PNKP237/EHU32/EHU32_wiring.pdf

PCM5102 module | ESP32 DevKit get one with an antenna connector for best results

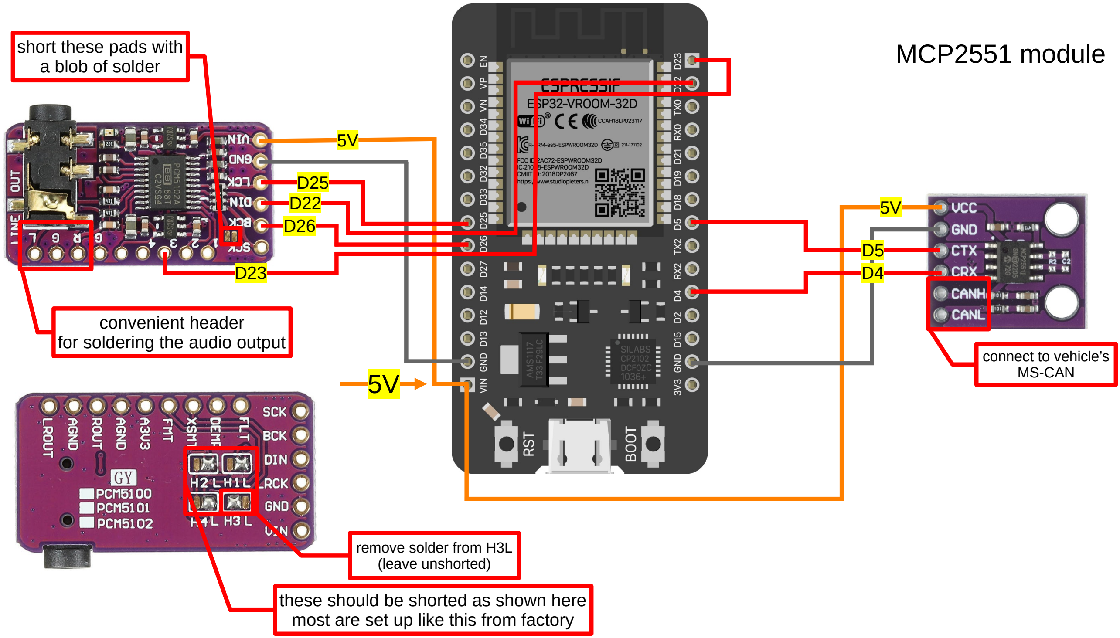
[picture p1: figure]
remove solder from H3L (leave unshorted); these should be shorted as shown here most are set up like this from factory; short these pads with a blob of solder; connect to vehicle’s MS-CAN; convenient header for soldering the audio output; MCP2551 module
