PNKP237/EHU32/(threads)

Thread 2 (2024-04-20):

About canUpdateDisplay() function

eticaretmuhendisi, 2024-04-20:
Hello, congratulations for your project.
I am trying to make a simpler project. I found this version of the project a bit confusing. Could you please share the write to screen function in a simpler way?

PNKP237, 2024-04-20:
For writing to the screen, I would suggest taking a look at this: [Info-Display.md](https://github.com/JJToB/Car-CAN-Message-DB/blob/master/Opel/Astra/H/MS-CAN/Info-Display.md) and also at the small writeup on the [wiki page here](https://github.com/PNKP237/EHU32/wiki). Good understanding of [ISO 15765-2](https://en.wikipedia.org/wiki/ISO_15765-2) will probably make it easier to figure out and implement in your own application.

canUpdateDisplay() is only called when ESP32 detects the screen being written to by the radio unit (specifically, the first message). At this point there is few things that can be done:
- wait for radio to finish sending its text and then send our own text (results in flashing "Aux")
- prevent radio from updating the display by abusing flow control packets (will only work if we're faster than the display in acknowledging the transmission). This is the prettier option becuase "Aux" is not shown at all.

Updating the display is somewhat convoluted in the case of EHU32 because I opted to make it possible to update from various sources, make it flexible and memory safe (to the best of my ability). The functions operate on 1-byte buffers existing in the global scope: utf16buffer (formatted text, converted into UTF-16, with everything calculated, modified by utf8_conversion), CAN_MsgArray (utf16buffer split into packets as per ISO 15765-2, ready for transmission, modified by prepareMultiPacket).
The process of writing text to the display is as follows:
- call prepareMultiPacket(utf8_conversion("string one", "string two", "string three"));
- make sure the radio is not sending a message of its own,
- transmit ONLY the first message from CAN_MsgArray (sendMultiPacket does this, sets the flag - CAN_MessageReady - for the main loop to act upon),
- wait for the display to acknowledge with a flow control message (main loop does this based on the flag, waits for the message from the display with ID 0x2C1),
- send rest of the messages from CAN_MsgArray (calling sendMultiPacketData does this until the packets do not contain the consecutive frame index)

It is also good practice to make sure the messages are sent successfully and aborting the transmission in case of even a single error.

Thread 3 (2024-05-04):

Additional information without electric climate

Vortecsz, 2024-05-04:
Hello, would be possible to display coolant, speed, rpm and voltage without the Electronic climate? I know how to activate the electronic climate tab in the bottom but I don't have the automatic climate so this is useless for me. Would be possible to show maybe the coolant and battery in the first page of the screen without auto climate? If not why? The data are pulled from the ECC or is something related to the print on the display? If the problem is the ECC I could search for the different address of the data's in the can line? If the problem is the print why I couldn't print in the first page? Thank you so much for the work!

PNKP237, 2024-05-04:
Battery is out of the question for now, I haven't been able to come up with a way to read battery voltage from MS-CAN other than through ECC.
As for coolant temp and vehicle speed, it is possible to read it using measurement blocks from the display (but then there's no RPMs nor voltage). I'll try to implement that in the next version (it will try reading reduced data from display if there is no response from ECC) - I guess you can expect the new version in one or two weeks, still optimizing and testing stuff.
As for why - it uses the same protocol that OPCOM or Tech2 use for reading measurement data and only ECC offers coolant temp, speed, rpms and voltage combined. If these tools can't access more data from display or radio neither can we.

Haven't had much luck with sniffing the coolant, rpm and speed data like it was defined [HERE](https://github.com/JJToB/Car-CAN-Message-DB/blob/master/Opel/Astra/H/MS-CAN/Body.md). In my case (Z16XER) I was reading total garbage, but once I get reading basic data from the display done I'll try again with these.

Vortecsz, 2024-05-04:
Love to hear that, it would be possible to display like the coolant in the first page? I would like to have the coolant temperature in the main page without need to swap page everytime

PNKP237, 2024-05-05:
First page as in the mode where song data is shown? I guess I can make it like this but it would require me to rewrite a lot of current logic.
I would much rather show the coolant temp in a "notification box" that sometimes appears in the top right corner of GID/CID, able to be toggled on or off. Do you think that would work for you?

Vortecsz, 2024-05-05:
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
That's my current setup, in the top the current media, like aux etc in the bottom consumption etc, my main goal would be to add like coolant in the top right, but if is it hard, I would understand maybe one day I will understand how to program that haha. The notification box would be also not bad at all

PNKP237, 2024-05-05:
Alright, you have a single line GID so writing the coolant info to the album or artist fields won't work because you won't see them anyway. I had the single line version as well but I enabled UHP just to make it display all the three lines of text.
The notification box will work fine but it will obstruct the top right part of the display.

As for GID firmware, EEPROM only holds basic data such as settings and carpass (if paired with the radio). and the GID firmware itself is held inside this TSOP flash package I think, difficult to read that data without a TSOP adapter. Don't feel the need to modify the GID firmware anyway, I'd like this project to work plug-and-play with no modification to the rest of the system

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

Vortecsz, 2024-05-05:
Oh okay, would be possible to print in the top right with the single line gid? Or just you can't because u need to overwrite an existing text? Like artist aux etc. Btw with the the EEPROM firmware you can change different version 3 line version, single etc, but if you don't want to modify any firmware that's pretty useless.
I don't know if you know but a Russian guy seel an obd device probably something similar to your setup, that can show DPF status etc, that's only an idea for the project, I don't need DPF status etc. My main focus is to see the coolant temperature and maybe battery in the main page as stock as possible. Because Opel decided to not add any temperature gauge in the cluster...
Thank you for the help.

PNKP237, 2024-05-05:
Yes the notification box can be displayed even with single line GID.
As I have already stated in the [other issue](https://github.com/PNKP237/EHU32/issues/1) there is no way to read DPF status from MS-CAN and that's the only CAN bus I'm going to support in this project, mainly because ESP32 only has a single CAN peripheral. Otherwise I would need additional hardware to be able request DPF measurement blocks from ECU through HS-CAN.
I recently learned that such module exists but making menu interfaces is not something I would like to focus on at this time even though I have already reverse engineered how the menu can be created.
The problem is that if this is put in a vehicle equipped with UHP it could cause problems because that module "fakes" being an UHP interface menu

PNKP237, 2024-05-05:
Nevermind, the notification box does not show up when the main audio page is displayed. I guess I'll try to fit coolant info on the right of the middle line or find another way to display notifications
I'm surprised you prefer the single line version though

Vortecsz, 2024-05-05:
Oh okay, I prefer the single line because I watch a lot the consumption and the autonomy of the car so I would need to swap page every time. The first page of the three line only display audio information and I only use aux so I would of see aux and nothing more. I prefer to see the consumption

PNKP237, 2024-05-05:
The display is not very good at handling longer strings and as a result the coolant temp is printed on top of the title text. Sometimes it's ignored and not printed at all, for very long song titles

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

I don't know if I should go ahead with this, the result is kinda bad

Vortecsz, 2024-05-05:
You are right, that's not good at all for posting it, I don't know if you can put the string down the song or you can just write in the line of artist/song name. Btw can you give me the code? I can use the coolant on the right of the AUX string? Because I just use aux so is not a problem for me and thank you for all the help and the amazing work you are putting in the project.

PNKP237, 2024-05-05:
You can't "add" anything to the AUX string sent by the radio, you can only overwrite it.
I built this test version on top of EHU32 which is still not ready for release, but once it's finished I'll give you the code with this functionality added, with a way to customize the text displayed to your liking

Tomi8609, 2024-05-06:
I will keep an eye on this part of the project!

PNKP237, 2024-05-06:
Just pushed v0.9, added an additional mode (accessible by long pressing "3") for displaying just the coolant temp in a single line, looking like so:
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

Vortecsz, 2024-05-07:
That's beautiful thank you so much for the work! Currently waiting for the esp and the modules to arrive to get it working.

Wop57, 2024-05-12:
There is an example for showing information in the electronic climate tab. It is in the issue #3 in the Car-CAN-Message-DB of JJToB. Here is the link:
https://github.com/JJToB/Car-CAN-Message-DB/issues/3

PNKP237, 2024-05-12:
> There is an example for showing information in the electronic climate tab. It is in the issue #3 in the Car-CAN-Message-DB of JJToB. Here is the link: [JJToB/Car-CAN-Message-DB#3](https://github.com/JJToB/Car-CAN-Message-DB/issues/3)

Thanks, never noticed that one.
Even though I have considered showing the temperatures there it still does not solve the underlying issue - if the car does not have ECC (or at least not enabled in Display Variant Programming, changing which requires opcom, which kinda defeats the "as cheap and easy as possible" approach) then we can't utilize that field.

Already tested with UHP but it does not send any notification boxes, only menu-like screens.
I'll do some additional research to see if I can simulate Navi notifications, but that has to wait since I'm super busy with other things. Also I need to get the CD ROM drive back into my Navi since it refuses to display anything without the drive mechanism.

Vortecsz, 2024-05-15:
Hello is possible to change the pinout with this board?
CP2102 Type-C 38P

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

PNKP237, 2024-05-16:
I don't exactly understand what do you mean by "change the pinout", please elaborate.
Is it just changing the pins, as in you'd prefer the CAN TX/RX or I2S on different pins than provided in my example?

Vortecsz, 2024-05-16:
Oh yes sorry, I searched for the defaults pin out of can Rx tx and i2s, example for can Rx and tx io4 and io5  wired them up in my esp board but isn't working at all. Maybe is the board? And I need to define manually the gpio? I find that the default pins are the same for the 38 pins board and the 30 pins board so I don't know why isn't working

Vortecsz, 2024-05-16:
After reflashing the esp every time I connect the board to the car the aux text go away and the current date is displayed is like the radio doesn't work because the buttons don't do nothing but I can hear the sound from the speaker so the radio is on. If I remove the esp everything work as usual

PNKP237, 2024-05-16:
Curious. I do most development on a setup like yours (GID and I assume CD30MP3) and never had the radio stop responding. What model year is your vehicle?

PNKP237, 2024-05-16:
i2s is just an output and if you leave it not connected it does not matter to the ESP32 at all (it doesn't receive any data from PCM5102).

EHU32 will enable bluetooth and start sending stuff to the screen after it notices that the radio has sent some text to the display, it starts with the "1" mode active (audio metadata). You don't have to connect to switch to the "3" mode (1-line coolant info).

If you can, please download version 0.7 from releases and try connecting your phone and playing something to see if the audio title is displayed at all. Of course it won't have the "3" mode and "2" won't work but I would like to see if the "radio message blocking" feature is the problem here (v0.7 is the last version without it).

Vortecsz, 2024-05-16:
Okay, my problem is the 5v and grounds using a car charger with USB port. Gonna try others configuration. Anyway mode 1 work with song names, mode 2 show coolant hope I'm correct, mode 3 show speed and rpm, the rpm and speed are wrong when I'm idle at 800 it shows 3000 same for the speed I'm going 90kmh and it shows 45. Mode 2 coolant is partially wrong if I long press settings and after bc I can access the secret menu of the gid and I can see the little difference between the two coolant value, your is a bit high like 3/4 °c. The audio quality sucks, but that's my problem with the connection, I would love to see you PCB design did you manage to get that done?

PNKP237, 2024-05-16:
It's the other way around, mode 2 should show speed and RPMs and if there is no ECC detected it will try to pull that data from CAN but as I said earlier in my vehicle I would read random values so I haven't had much luck testing that. I guess I'll remove that option from next version since it doesn't work that well - I'll make it only show speed that's read from the display.

I think that the ground of the audio input in CD40 might be either floating or coupled with caps to ground, I'd suggest to measure with a multimeter between the audio input ground and vehicles ground to see if there is any voltage there. If there is then one fix would be to either modify the radio or buy some kind of an audio separation transformer.

Thanks for the feedback, I'll correct the speed display (just divide it by 2 I guess?) when I have some free time next week to possibly test it within my vehicle. As for coolant I'd say it's the GID that's lying since these cars notoriously run hot.
As for the PCB... I'll get around to finish it one day but I've got a lot of things going on right now.

Vortecsz, 2024-05-16:
Okay I resolved all the problem with the connections, the problem is that the audio quality sucks really bad. I don't know why the power is from a car charger with a USB cable, not from the radio.

PNKP237, 2024-05-17:
I hope your PCM5102 isn't broken, here's a test program for you to flash the ESP32 with, please connect it to an amplifier at home so you can check whether the audio output works properly. It has no CAN functionality so you can connect to it and just play music from your phone.
[ESP32_Audio_Stereo.zip](https://github.com/PNKP237/EHU32/files/15345653/ESP32_Audio_Stereo.zip)

Vortecsz, 2024-05-19:
As soon as I have a chance I'll try it thank you very much. Just a question: the ESP power supply should be given through the USB connector or i can give it directly to the vin and gnd pins?

PNKP237, 2024-05-20:
Yes, you can power the board through the VIN pin, on some boards it's connected the same 5V line as the USB VBUS pin, on other boards it's connected through an additional diode. Just make sure you don't power the board through VIN and through the USB connector (from PC) both at once.

Vortecsz, 2024-05-20:
Perfect all working i found some problem; the qualitify of the music is not the best, the sound has some distortion in the background, i'll attach a video below. Sometimes the esp(i think) crashes and the bluetooth is disconnected, and the can also, after some seconds it recconect automatically. Did your setup also have some distortion noise with the aux? I have an aux bluetooth buyed from amazon and it doesn't has background noise

https://github.com/PNKP237/EHU32/assets/61433353/eaeeabb6-ca29-4399-9362-cfa626972faa

PNKP237, 2024-05-20:
I found that the ESP is prone to crashing when the 5V source is not very good. Did you try with additional electrolytic capacitors soldered to the ESP32 board, between VIN and GND? ESP32 is way more power hungry compared to those bluetooth audio boards found everywhere, which is what I used before. My own setup uses a linear 5V regulator (7805) taking power from the radio itself with many additional capacitors on the 12V and 5V lines.
Distorted sounds like in your video do happen in case the I2S driver has no new data to process (it loops the last received music sample, often when bluetooth gets disconnected or gets out of range) or during a crash, but it's never that long, maybe 1 sec max.
I have honestly not used the external aux much since I bought a CD70 from scrapyard and it has no aux circuitry (therefore my EHU32 is soldered inside the radio directly to aux). Although I did test it briefly with the original CD30MP3 (EHU32 connected to external aux and OBDII port) my car came with and I only had some slight noise from unsmoothed DC-DC converters when I tried to power it with the worst quality step down board I could source.

Vortecsz, 2024-05-20:
I'm currently taking the power from an 12v car charger, so i don't think the power sucks. I can use the 7805 as you said? Right now i'm testing all the setup, i'm planning to take the power from the radio as well. For now i can use the 7805 after my car charger (5v)? That one? ; [https://it.aliexpress.com/item/1005006104819794.html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](url)

PNKP237, 2024-05-21:
I should probably clarify in the readme that you should not use the phone's volume control and leave it on max since volume control on I2S results in the audio quality getting worse (the lower the volume, the less bits per sample of audio there is).
Only use vehicle's volume control and optionally you can go into CD40 settings and modify the "Aux in volume" to a value of -5 to lower the noise floor.

The best setting for the CD30 family (so CD40USB as well) would be to use the 7805 inside the radio, it makes the experience more seamless since it powers on/off with the radio itself by using the switched 12V or 8V voltage rail inside the radio unit, but an ESP32 module with an antenna is highly recommended because the radio cage acts like a shield. I actually did test it inside the CD30MP3 as well and the method of connecting it inside should work for CD40 as well.
As for caps I think I've got 470uF + 100nF on the input of the 7805 and 1000uF + 100nF on the output, additionaly there is a 220uF cap soldered directly to the PCM5102 board. MS-CAN is hooked up directly to the legs of TJA1041 CAN transceiver, audio is soldered to the internal AUX vias. Power can be taken either from switched 12V (on the tab of this large SOT-223 package on the right) or from a 8V rail powering the CD drive.
Here are the photos of the mod:
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
Internal Aux vias:
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
white is left channel, black is audio ground, red is right channel

Vortecsz, 2024-05-22:
Thanks so much, I'll follow your "schematic" as soon as I can. Btw,my radio hasn't worked in FM mode for a year now, it remains in search and no noise is emitted, do you have any idea what it could be?  Has it ever happened to you? Sorry for the OT

PNKP237, 2024-05-22:
I had the radio in my old insignia do it when it got very cold outside (like -10c) but as for cd30 and cd70 there was no issues with the FM reception. My guess is cracked solder joints or a fault with an antenna, next time you will be removing the radio unit from the vehicle try fitting a long wire antenna in place of the antenna connector while leaving the other connector in place so you can test with a substitute antenna.

KingSilverHaze, 2024-09-29:
I think this project is great. I bought the ESP 32 WROOM 32U and flashed the software v0.9.2. Unfortunately I can't get a Bluetooht connection. The name is not displayed with the Bluetooht devices. I then flashed ESP32 Audio Stereo for testing. The Bluetooht name ESP32 ADP is displayed, but no connection is established. What is the error?

PNKP237, 2024-09-29:
> The name is not displayed with the Bluetooht devices.

With release versions, the bluetooth connection is only available when the board is connected to the vehicle's MS-CAN bus (pins 3 and 11) using a CAN transceiver module (such as MCP2551, SN65HVD230 or TJA105x). Once both the radio and the car's display are on then the bluetooth part is initialized.

As for ESP32_Audio_Stereo not working it could be that the board is reset when trying to connect, I'll investigate with my boards.

KingSilverHaze, 2024-09-30:
Thank you for your answer. I have installed it in the CD30MP3 and it works perfectly. The car is a Corsa D. Only the speed is displayed too high. But it is important to me that it works with the Bluetooth stream. Hope this project continues, it's a great alternative for an older vehicle.

Thanks for your work and the know-how.

PNKP237, 2024-09-30:
Glad it works - thanks for the feedback.
I'm working on an update and I'd like to fix the speed readout - if you can, please tell me what speed value is displayed on the screen when you're driving, for example: 20 km/h, 50 km/h, 70 km/h (shown on the speedometer). This way I'd be able to correct the conversion.
Also provide me with an engine code of your vehicle for clarity.

KingSilverHaze, 2024-10-02:
Today I looked at how the values are displayed.
It is the A14XER engine.

The RPM shows 3500 and the EHU32 shows 1400 RPM.
When idling, the EHU32 shows 3000 RPM.
When I drive at 130, the EHU32 shows 60 - 65.

PNKP237, 2024-10-02:
Thanks for taking the time note down the data. Earlier, you said that the speed was displayed too high, but at 130 km/h it was showing half the actual vehicle speed, is that correct?

NME157, 2024-10-20:
Hello,

Thank You for your great input! I was looking for something similar and what I found is even better. Just wanted to ask if it is possible to connect mic that esp32 would act as handsfree device? What code changes should be made? Btw,will it show on the screen the name of the caller as it is now or code changes should also be made?

PNKP237, 2024-10-20:
>Just wanted to ask if it is possible to connect mic that esp32 would act as handsfree device?

There's currently no support for Bluetooth HFP profile under arduino from what I was able to gather, but if I manage to move away from the arduino core I'll try to implement basic HFP where you can hear the caller through the car's speakers but it will still use your smartphone's microphone.
Showing caller ID and stuff like that should be easy if I can manage the first part.

NME157, 2024-10-20:
> > Just wanted to ask if it is possible to connect mic that esp32 would act as handsfree device?
>
> There's currently no support for Bluetooth HFP profile under arduino from what I was able to gather, but if I manage to move away from the arduino core I'll try to implement basic HFP where you can hear the caller through the car's speakers but it will still use your smartphone's microphone. Showing caller ID and stuff like that should be easy if I can manage the first part.

Thank You very much for quick reply!

NME157, 2024-10-21:
By the way,one more question - song name and artist is only displayed of music is played by phone player or does it display info even of music is played from Spotify?

PNKP237, 2024-10-21:
Depends on the application playing the music, but in my experience it works with all default music players, YouTube app and Spotify. Works with Spotify on iPhone as well.

PNKP237, 2024-12-08:
Hello guys, back to the topic on hand - engine coolant temperature problem
Here's what I got working, coolant temp being displayed on top of the audio metadata:
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

This window can be updated separately from the audio stuff which makes it easier. It also works without electronic climate control, it does not even have to be enabled in variant programming (no need for opcom, just plug and play), nor does it influence the temperature set on the AC panel, so no need to worry that the car will start blasting you with 90C+ air.
There's just one downside, if the temperature exceeds 99 deg C, the degree symbol won't be shown, but still I'll try to implement it in v0.9.4.

Tomi8609, 2024-12-10:
Hello

How often does this window pop up or is it there all the time?
Is it possible to display the battery voltage in the same way?

PNKP237, 2024-12-10:
It can be there all the time, constantly updating or be shown for just 5 seconds (just like AC does).
As for battery voltage, this window only fits 3 characters so no decimal point, seeing a battery voltage like "12V" or "13V" is a little pointless.

Tomi8609, 2024-12-10:
I understand

Thank you

Tomi8609, 2024-12-10:
I think it's enough if it's only visible for 5 seconds

PNKP237, 2025-01-11:
I tried this but for some reason my GID (from a 05 vectra) wouldn't respect the formatting sequence. Not sure what's the issue here but I'll try again some other time.

devilsoul13, 2025-01-13:
hello I love this project it's been a long time that I want to interact with the canbus of my astra h from my side I want to display the information of my cid on a tablet or a phone can you help me out? what would I need as a canbus module to read the information? what is the cabus line for this information (ms can lcan h can) for the development part of the application no problem but I do not know what hardware to use to communicate with the canbus. thanks

PNKP237, 2025-01-13:
The display is connected to both LS-CAN (GMLAN) and MS-CAN so if you wanted to replicate its functionality you'd have to read data from both buses. You could use bluetooth serial port to transmit CAN data to your tablet.
ESP32-C6 is pretty good if you want to interface with two CAN instances. There are cheap C6 development boards you can use with some CAN transceiver modules like MCP2551 or TJA1051. Classic ESP32 (like the one EHU32 runs on) only has one CAN peripheral. In terms of hardware, look at the .pdf "schematic" in the root of this repository.
STM32F4 boards are also pretty good if you don't need bluetooth/wifi, some of them even have 3 CAN peripherals.

devilsoul13, 2025-01-13:
first of all thank you for the speed of your response.
in my country (Tunisia) there are these cards
can you tell me which is the best because there is a big difference in price.

https://www.celectronix.com/cartes-et-kits-stm32/2810-stm32f4-discovery-stm32f407g-disc1.html
https://2btrading.tn/accueil/8778-carte-de-develeoppement-esp32-c6-devkitc-1-8mb-spi-flash.html

with which canbus I have to work MCP2551 or TJA1051?

PNKP237, 2025-01-13:
> https://2btrading.tn/accueil/8778-carte-de-develeoppement-esp32-c6-devkitc-1-8mb-spi-flash.html
Get the ESP32-C6 then, it's easier to work with under arduino or ESP-IDF compared to STM32. Setting up bit timing is also easier with ESP32. The ESP TWAI driver isn't perfect but works well enough if you're not transmitting much.

> with which canbus I have to work MCP2551 or TJA1051?
any CAN transceiver module will work for MS-CAN or HS-CAN (for example SN65HVD230, TJA1051, TJA1050) just get whatever is cheaper for you. Remember that one board can only handle one CAN bus.
as for interfacting with LS-CAN it's more complicated because it's a single wire CAN line, for reading data you could just use a transistor to invert the signal but for transmission/receive combined an actual SWCAN transceiver is pretty much required, I used MIKROE-4225 because it's pretty much the only SWCAN module available locally

devilsoul13, 2025-01-13:
I would like the most efficient and easiest solution especially for assembly to avoid soldering errors and other

devilsoul13, 2025-01-14:
what do you think about can shield and arduino ? beacause its simple to connect (plug and play)

PNKP237, 2025-01-15:
Classic arduino (atmega328 I guess?) is slow and canbus shield is an external CAN peripheral (MCP2515) and as such it'll be even slower (runs over SPI). Also MCP2515 (not to be confused with CAN transceiver MCP2551) can't run on MS-CAN by default because the timing is wrong (can't set 95kbit unless the clock crystal is changed). It can only support only a single CAN bus at a time.
Just buy jumper wires to connect the boards

devilsoul13, 2025-01-16:
ok THANKS .
so the best configuration for my project would be :
https://2btrading.tn/accueil/8778-carte-de-develeoppement-esp32-c6-devkitc-1-8mb-spi-flash.html
and x 2 https://2btrading.tn/accueil/624-module-sn65hvd230-can-board.html
(2 canbus sn65 one for ms and one for ls can)?

PNKP237, 2025-01-17:
Yes that will work but only for MS CAN and HS CAN. Regular CAN transceivers won't work for LSCAN because it's physically different, it only uses a single wire.
For LS CAN you will need something like [MIKROE-4225](https://www.mikroe.com/single-wire-can-click).

Tomi8609, 2025-01-17:
Hello

I would like to create the following project:
[https://github.com/ElKaPa/opel-can-swc-adapter](url)
Can you help me with what I should change in the ino file to enter the secret menu by long pressing the two phone buttons on the left side? This works with the "Setting" button on the original radio and the "BC" button is used to step through the menu.
- 201#01FF00 - Enter the BC menu
- 201#01C000 - Return to BC

devilsoul13, 2025-01-17:
Great but for displaying cid info I think I don't need ls can for exemple for radio and climate control.
And for engine info I can use simple Bluetooth elm327 with tork app

PNKP237, 2025-02-03:
> Great but for displaying cid info I think I don't need ls can for exemple for radio and climate control. And for engine info I can use simple Bluetooth elm327 with tork app

Hope you don't intend to remove the orignal display module since CID reads vehicle data directly from LS-CAN and retransmits that data on MS-CAN so without the original display MS-CAN is pretty much dead so unless you're able to replicate the authentication/anti-theft system stuff like radio and climate control will not work at all. If you want your project to run alongside the original display then it's fine.

> Hello
>
> I would like to create the following project: [https://github.com/ElKaPa/opel-can-swc-adapter](url) Can you help me with what I should change in the ino file

Sorry but the project you're referencing uses a different CAN adapter which I don't know how to use and don't really have the time to learn to understand it.

devilsoul13, 2025-02-03:
> > Great but for displaying cid info I think I don't need ls can for exemple for radio and climate control. And for engine info I can use simple Bluetooth elm327 with tork app
>
> Hope you don't intend to remove the orignal display module since CID reads vehicle data directly from
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

Thread 4 (2024-08-03):

Core dump check failed

kybok12321, 2024-08-03:
Hello, please tell me what could be the reason? I installed the firmware using ProgramESP32.bat and after rebooting the board in SerialMonitor it gives the following error:

rst:0x1 (POWERON_RESET),boot:0x13 (SPI_FAST_FLASH_BOOT)
configsip: 0, SPIWP:0xee
clk_drv:0x00,q_drv:0x00,d_drv:0x00,cs0_drv:0x00,hd_drv:0x00,wp_drv:0x00
mode:DIO, clock div:1
load:0x3fff0030,len:1344
load:0x40078000,len:13964
load:0x40080400,len:3600
entry 0x400805f0
E (587) esp_core_dump_fl���h: Core dump data check failed:
Calculated checksum='de456912'
Image checksum='ffffffff'

PNKP237, 2024-08-04:
I don't think that's a problem, from what I can gather it's normal since there is no core dump on your ESP32 (the program hasn't ever crashed, therefore there's no valid crash data in there). Have you used your ESP32 board for some other program before?
Does the board reboot continuously?

kybok12321, 2024-08-07:
Thank you very much for your reply and for your excellent work on this program. After this error nothing happens, the board does not reboot. After pressing the reset button I noticed that the check engine briefly lights up and goes out, but nothing else happens. Unfortunately I didn't have the mcp2551 chip board available so I changed to a TJA1050 I2C chip, could this be the problem? Also I don't see bluetooth to connect to. The Esp32 board is in good working order, other programs with bluetooth operation were running on it. Can you please tell me, what should be the behavior of the tape recorder or the car when starting the board? I also tried to compile in Arduino IDE, but I get a lot of errors, one of them is in line 13 of A2DP.ino file : 'title_buffer' was not declared in this scope

PNKP237, 2024-08-07:
Can you send a link to the exact type of ESP32 board you have? A detailed photo is fine too.
I tried all the boards I have around and couldn't replicate the issue, even tried fresh ESP32-WROOM modules straight from the tape and they seem fine. You can also show me the full output after running ProgramESP32.bat.

TJA1050 should work, but I have not tested it myself. Bluetooth only starts after ESP32 receives a message from the radio to the display, then prints a message "Bluetooth on, waiting for connection" (ignition is not necessary), afterwards the bluetooth is available to connect to. What is your vehicle, display and radio unit?

As for compilation, I think you're using an older version (1.x.x) of arduino IDE, update to something newer than 2.x and it should compile fine. While compilation will succeed, there's still an issue with the newest release of ESP32 arduino board files, CAN seems to crash very often with these, also the resulting file will not fit in memory unless you modify the ArduinoOTA library. I'd suggest downgrading to 2.0.17 version of the ESP32 board files for everything to work properly (don't forget to do what I have described in [this section of readme](https://github.com/PNKP237/EHU32?tab=readme-ov-file#compilation-notes) after downgrading/upgrading the board files).

kybok12321, 2024-08-07:
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

kybok12321, 2024-08-07:
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

PNKP237, 2024-08-07:
I've got the same board in my test setup and it works well, same serial chip and all.
Here are the settings.
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

kybok12321, 2024-08-07:
Can you please tell me the versions of your libraries to compile?

PNKP237, 2024-08-07:
ESP32-A2DP v1.8.3
arduino-audio-tools v0.9.8
esp32 board files v2.0.17

Also, I've got one thing for you to try, maybe erasing the entire flash before programming will work in your case. Use the attached batch file to program your board.
[ProgramESP32_erase.zip](https://github.com/user-attachments/files/16532697/ProgramESP32_erase.zip)

kybok12321, 2024-08-08:
Super, thanks a lot, everything compiled perfectly now. However, the problem is still the same, no response. I assume I have wrong soldering, can you tell me if CAN High from TJA1051 is connected to Can high in OBD2 pad (pin 6) and CAN Low is connected to Can Low in OBD2 (pin 14)? When I press RESET on the board, what happens in the video, is it supposed to happen?

https://github.com/user-attachments/assets/5603b010-11f0-464a-976c-0c9c7da23fac

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

kybok12321, 2024-08-08:
That's what it was all about! Thank you so much, everything works great. I didn't know Opel had a separate CAN line, I was using the standard obd2 pinout.

Closed 2024-08-08.

Thread 5 (2025-01-11):

Battery voltage from TID/BID/GID

xymetox, 2025-01-11:
Hello.
I researched BID/GID and found UUDT request to get voltage from display without electronic climate control (ECC).
To get voltage from display in MSCAN bus you should send UUDT request id246 with PID13 to display.
You should get UUDT response id546 with voltage measured by display. It may differ from battery voltage. It is necessary to make correction. BID reduces voltage by about 0.5V.
For example you send single UUDT request with PID13 to display:
id=0x246 dlc=8  0x03 0xAA 0x01 0x13 0x00 0x00 0x00 0x00.
You will get voltage (multiplied by 10) measured by display in byte 6 of UUDT response message:
id=0x546 dlc=8  0x13 0xXX 0xXX 0xXX 0xXX 0xXX 0x72 0xXX.
In my example byte 6 = 0x72 HEX = 114 DEC= 11.4 Volt voltage measured by display.
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

PNKP237, 2025-01-11:
Very nice, thank you for sharing your research! I'll try to add it to the wiki page in this repo and then make changes so the "measurement display mode" is identical whether the car is equipped with ECC or not.
Have yet to find some motivation to continue working on this, but I hope I'll get something done before March.

Closed 2025-04-06.

Thread 6 (2025-02-03):

Stuttering audio

xddxd, 2025-02-03:
Hi,

So I’m having the same issue as the person on #1 , the audio on an iPhone 15 Pro running iOS 18.3 is crackling, stuttering and jumping. Meanwhile a Nokia 8 on Android 12 (PixelExperience 12.1) is playing almost flawlessly (have to keep audio down on the phone down otherwise clipping happens). I don’t know what codec or sampling rate the iPhone is using, but the Android connects using SBC and 48KHz.

PNKP237, 2025-02-03:
I used an iPhone 15 (non-Pro) in my vehicle with EHU32 and tested it extensively since I knew that the underlying library for handling A2DP audio has had problems with iOS devices in the past but never had any issues. Found something else here with a suggested fix: [SOLVED Poor quality audio from IOS devices. #582](https://github.com/pschatzmann/ESP32-A2DP/discussions/582)
Certain ESP32 boards seem to be an issue here.

Made a build of EHU32 v0.9.3 with the data out pin changed for you to test (also compiled with updated libraries). Can't really test it on my hardware.
Before you flash your board please remember to connect the DIN pin on PCM5102 to D19 (instead of D22).

[EHU32_093_DOUT_19.zip](https://github.com/user-attachments/files/18647029/EHU32_093_DOUT_19.zip)

Also please describe your board, is it the type-C version? What's written on the metal shielding? What USB-UART chip is on the board, is it the CP2102 or WCH something or other?

xddxd, 2025-02-03:
I’ll try out this version and report back, I can’t tell what is written anymore because the esp32 is glued into a box and is upside down.  I do remember the UART chip being an obvious clone though. Safe to say the rest of the board is likely chinesium.

I have to say though, amazing work, I hate aftermarket radios and this is just perfect, almost jumped out of my chair when I found this.

PNKP237, 2025-02-03:
Got myself an older iPhone for testing but I would appreciate it very much if you could take the time to describe/photograph the board in detail, I've got many variants in my collection but testing each one of them is not feasible, so I want to narrow it down to the problematic ones and work out a fix (mainly for other people attempting to put this together).

I'm in similar boat here since this project is partially a product of my disdain for aftermarket headunits which look out of place and don't integrate with the car like the stock headunits do. Also, how often do you see Aux displayed? I'm still in the process of refining the display blocking/overwriting logic but you're the first person with anything other than CD30 sharing feedback so I'd like to ask. I do most of the development on CD30MP3 with GID and EHU32 works seamlessly with that but each time I test new code with CD70 there's always something that doesn't work exactly right, still getting Aux to show up here and there (probably RDS and navi data getting through and messing with my logic). Not to mention that debugging is difficult when you've got to focus on driving. Hope you understand my frustration here.

xddxd, 2025-02-03:
Aux does randomly pop up yeah, I haven’t noticed a pattern though. Sometimes it doesn’t pop up for a long time, sometimes the text goes blank for half a second and goes back to normal.
There’s some character limit too it seems, if the first and second lines are really long the 3rd line gets cut off and ends with a "ÿ”.
Also voltage display is incorrect, shows anywhere between 18-24V, sometimes 4V and doesn’t react to actual voltage changes so it probably is reading bogus data. Likely a difference between Astra H/Zafira B and Vectra C/Signum ECC units.

Aside from that, having steering wheel control on bluetooth is amazing, I should be able to provide you with pictures of the ESP tomorrow. I also tried an iPhone 11 but it exhibited the same audio issue. Looked 100% like a Bluetooth issue, I muted the iPhone but audio was still playing.

xddxd, 2025-02-04:
Here are some board pictures.

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

PNKP237, 2025-02-04:
> There’s some character limit too it seems, if the first and second lines are really long the 3rd line gets cut off and ends with a "ÿ”.

I might try to extend the buffer data to support up to 512 chars in some later versions. As for ÿ showing up that's rather strange, unfortunately I don't have a CID on hand to investigate.

>Also voltage display is incorrect, shows anywhere between 18-24V, sometimes 4V and doesn’t react to actual voltage changes so it probably is reading bogus data.

In the next release I'll be moving away from reading data from ECC and read all the data (including voltage) from the display. Hopefully that will work better across different models

>I muted the iPhone but audio was still playing.

That's actually proper behavior since I have forced the audio receiver to NOT apply any volume control and iOS respects that, unfortunately android's behavior varies with manufacturer and once it detects no volume control it applies the volume correction locally before sending the data off to the bluetooth receiver. Not only does that reduce the audio quality (lower dynamic range) but also can result in clipping (as you have observed with your Nokia smartphone). Not much to be done about that other than setting the volume to 50% and hope no correction is applied.

xddxd, 2025-02-04:
Images of the “ÿ” bug.

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

PNKP237, 2025-02-04:
Thanks for the photos, tried the same album/title/artist (from apple music) with GID but it works fine here but gets cut off earlier. Can you tell me what's the GM part number for that display? I vaguely remember that some vectras and signums had an early CID model (siemens vdo too) that only has two lines of data on the vehicle tab (the rightmost one), is it that one?
Have you been able to check whether moving the I2S data out pin to D19 changed anything in terms of playback?

xddxd, 2025-02-04:
Hi, swapped the pin and flashed the software, no change in iOS but Android now plays fine upto like 80% volume. Display is 24461297.

PNKP237, 2025-02-04:
Right, thanks for trying it out and all the feedback, I'll do some testing with the iPhone and different ESP32 boards over the upcoming weekend. Also, if you have some spare time and any other ESP32 boards at your disposal you might wanna try testing with them.

xddxd, 2025-02-06:
I do have more boards, unfortunately they’re from the same batch and identical to the one I’m using, doubt they’re going to make a difference.

PNKP237, 2025-02-09:
Do you happen to have an aliexpress listing for that board? I have tested 5 different ESP32 boards today and couldn't replicate the issue, audio is fine with an iPhone X running iOS 16.7.10 playing music from Spotify.

<details><summary>Click here for a photo of the tested boards</summary>
<p>

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

</p>
</details>

One of the boards is from WeAct, others are random (ESP-WROOM-32, ESP32-WROOM-32D, ESP32-WROOM-32UE, ESP32-WROOM-32U). Note that your ESP32-WROOM-32D module visually differs from mine, it's likely that one of them is a clone (or both are clones).

marcev31, 2025-04-19:
Hi, I have the same problem as xddxd, the sound stutters on my iphone 13 pro max, I have an android tablet and it plays the sound normally, but the samsung s22 sound stutters. I updated the 0.9.4 firmware today, the problem remains.

PNKP237, 2025-04-20:
I really did try all the boards in my possession but couldn't reproduce the issue, even with iPhone 15 running the latest iOS (as of 2 weeks ago). Is it possible for you to get a different ESP32 board? Personally I'd recommend **WeAct Studio ESP32 D0WD v3** if you're able to get one for testing. All the other no-name boards seem really hit-or-miss with quality.

PNKP237, 2025-04-26:
Finally got some ESP32 modules where audio is stuttering on iPhones but works well with my android device. It honestly seems like some weird hardware issue since I can't find any workarounds for the issue (at this moment).
All the offending modules are designated as **ESP32-WROOM-32E** (certainly clones) and use BoyaMicro flash chip underneath the RF shield. Later this upcoming week I'll try to transplant this memory onto another ESP32 module to see if that makes a difference then we'll know for certain.
Here's a photo of one of the ESP32s exhibiting the issue, so you'll at least know what kind of a module to avoid.
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

kotucocuk, 2025-09-14:
The module in the photo has not caused me any issues and works flawlessly with both iPhone and Android.

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

Thread 8 (2025-04-30):

Increasing the range of the Bluetooth signal

Technolog83, 2025-04-30:
I tried installing a simple Bluetooth 5.0 into the CD70 and it was inside the metal radio case. The Bluetooth signal was excellent.

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

 I am currently using ESP32 and I have a weak signal. If I use a board with a built-in antenna and place the ESP32 inside the radio (near the bottom CD drive), the signal is almost non-existent. So I use the ESP32 board to connect an external antenna of this type:

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

The antenna is glued to the inside of the radio's front panel, next to the volume control. The Bluetooth signal is good, but not strong enough. Sometimes the connection is lost if the phone is in the back seat.

How can I increase the signal? What antenna do you use and where do you place it?

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

PNKP237, 2025-04-30:
It all depends on the quality of the ESP32 module used (not the board exactly, but the module with the RF shield itself) - I use a [similar antenna](https://www.aliexpress.com/item/1005001335343983.html) also placed in the same spot as you do and I get solid connection even 5 meters away from my car. You could either try a laptop wifi antenna (if you have some scrap laptops handy) or a different ESP32 module altogether.

It's very unfortunate that it's difficult to get quality ESP32 modules, some are made cheap missing antenna filter components while others produce issues like stuttering music with iOS. The [module I use](https://github.com/PNKP237/EHU32/issues/3#issuecomment-2121866276) seems to be original (based on the Espressif logo) but as with all that comes from aliexpress/alibaba you never really know exactly what's original.

StarX-2401, 2025-05-03:
I use an old bluetooth antenna from an old VAIO laptop which is threaded through one of the holes on the back of the unit and is just resting behind it, it works good for my Samsung A52s phone but not great for some phones such as my Galaxy S3. An IPEX to SMA antenna should work good, I've bought one to upgrade it from the laptop antenna, they are very cheap online (I paid £4 for mine off ebay).

Closed 2025-09-05.

Thread 14 (2025-08-26):

Enhancement Idea: USB and microSD Card Support

kotucocuk, 2025-08-26:
Hello! I recently came across your project and it looks fantastic. I haven’t had the chance to try it out yet, but I’ll be gathering the necessary parts soon to give it a try. It would be even more amazing if support for USB or microSD could be added in the future. Keep up the great work!

PNKP237, 2025-08-26:
Thank you for your interest in the project. As for microSD support - I have considered that idea once, even made a working prototype, but due to the limited flash memory (MP3 decoder and SD takes a lot of space) and SD card pins unable to be muxed on ESP32 (can't redefine SD card pins - some are already used for CAN communication) I had to scrap that idea. Well, maybe someday...
ESP32 modules with a bigger flash are difficult to come by, so that'd surely require a custom PCB.

USB support is unfortunately not possible at all because ESP32 does not support USB natively - the USB you see on the ESP32 boards can only be used for serial communication.

Thread 15 (2025-09-02):

BID screen problem

kotucocuk, 2025-09-02:
Hi, thank you for sharing such a wonderful project! However, I’ve noticed that the text on the screen doesn’t quite fit properly. Maybe write "BT connected" "BT disconnected" "Coolant : 70°" Here are a few examples below:

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

PNKP237, 2025-09-03:
Please test this one, just replace EHU32.ino.bin file with the one from the attached zip and reflash the board. I tried to optimize the strings to fit BID better, this will get implemented in the release version when I figure out a way to request the display info.

[EHU32_095_BID_optimized.zip](https://github.com/user-attachments/files/22124719/EHU32_095_BID_optimized.zip)

kotucocuk, 2025-09-03:
> Please test this one, just replace EHU32.ino.bin file with the one from the attached zip and reflash the board. I tried to optimize the strings to fit BID better, this will get implemented in the release version when I figure out a way to request the display info.
>
> [EHU32_095_BID_optimized.zip](https://github.com/user-attachments/files/22124719/EHU32_095_BID_optimized.zip)

Thank you for your interest. I will try tomorrow evening. Have a good evening.

kotucocuk, 2025-09-04:
Hi, i think bt messages enough but coolant still same

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

PNKP237, 2025-09-04:
Apologies, I only changed the string for data sourced from electronic climate, which your car lacks. Now it's fixed for the display as well, here you go:

[EHU32_095_BID_optimized_v2.zip](https://github.com/user-attachments/files/22142606/EHU32_095_BID_optimized_v2.zip)

PNKP237, 2025-09-04:
Is the coolant temp accurate compared to the one you see in the testmode (settings held for 5s, then pressing BC until coolant is shown)?
I'm asking because you're the first person with BID in their vehicle to use EHU32, I'd like to make sure it reports the temperature properly. I've got a BID but I only test it on my desktop setup at home, hence I only ever see the coolant value of 73 C.

kotucocuk, 2025-09-04:
> Is the coolant temp accurate compared to the one you see in the testmode (settings held for 5s, then pressing BC until coolant is shown)? I'm asking because you're the first person with BID in their vehicle to use EHU32, I'd like to make sure it reports the temperature properly. I've got a BID but I only test it on my desktop setup at home, hence I only ever see the coolant value of 73 C.

I haven’t checked the value by holding the BC button yet, but I’ll do it this weekend(saturday) and get back to you.

PNKP237, 2025-09-04:
Then I'm extremely happy that even a geography teacher was able to make use of my work and put it to use in their car :)

kotucocuk, 2025-09-05:
Hi, my trip was cancelled, so I was able to test it today. Based on the test, I believe it might not be showing the correct result.

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

PNKP237, 2025-09-05:
Okay, that complicates things, but it's good to know that BID does not report the temperature the same way GID and CID does. I'll try to find the correct value later next week since I have to set up BID with CD30MP3 to test it thoroughly (my usual testing setup is a GID with CD70navi).

PNKP237, 2025-09-05:
No need for that, I have my own custom tools to interact with the CAN bus directly so I can issue custom commands to the display.
Afterwards I'll prepare a special build of EHU32 for you to test in your vehicle. May I also know the year of your Astra and the engine code?

kotucocuk, 2025-09-05:
Okey, Opel astra H 2013 hatchbag A16XER

> No need for that, I have my own custom tools to interact with the CAN bus directly so I can issue custom commands to the display. Afterwards I'll prepare a special build of EHU32 for you to test in your vehicle. May I also know the year of your Astra and the engine code?

kotucocuk, 2025-09-14:
Hi, i completed the project and installed it in the car. The issue was resolved after starting the car, and everything is now displaying correctly. Thank you for looking into it. By the way, would it also be possible to change the music using the arrow buttons on the head unit?

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

PNKP237, 2025-09-14:
Hi, thanks for getting back to me, glad it works after all. Haven't had the time to set up BID with cd30mp3 this week.
Thank you for sharing the photo of the module as well.

As for the buttons, you mean the left and right buttons on CD30MP3, I think it could be done. I'll put it on my to-do list.
I have previously tested the 4-way button (present on older CD30MP3 and all CD70Navi) but it does not send any messages on the CAN network - it's strictly for Navi/radio use and there's no way to read the keypresses.

kotucocuk, 2025-09-22:
Maybe it can display on the EHU32/WELLCOME/OPEL/Bluetooh On. The OTA process takes about 90–120 seconds in total, and the progress from around 10% to 90% seems to take longer than the rest.

> Thanks. I've ran into the issue several times but always forgotten to fix it - the display is not exactly "frozen", EHU32 just keeps retransmitting the last message to overwrite Aux. I'll think of some placeholder text to put there when switching from vehicle data to audio metadata. Out of curiosity, how long did the OTA update take? About one minute or longer?

kotucocuk, 2025-10-05:
Hello,

On Friday, I took an uninterrupted drive of about 4 hours, which gave me a chance to examine the EHU32 in more detail, and I encountered a few issues.

First issue: After using the speed display mode for around 30 minutes, the head unit makes a “click” sound and restarts itself. This problem does not occur when displaying the song title or the “coolant” text. My father experienced a similar issue in his car, which was caused by a “Yatour USB AUX” device.

Second issue: After pressing the steering wheel play/pause button repeatedly 4–5 times, the communication between the head unit and the BID screen was lost. On the BID screen, only the “instant consumption” message remained displayed. Turning the head unit off and on again did not solve the issue. When I turned off the car ignition and tried to restart the head unit, it would not turn on. However, after allowing the car to enter sleep mode and then attempting to turn it on again, everything returned to normal operation.

Today, I took another drive of about 2–3 hours without using the play/pause button and without using the mode where I experienced the first issue. The head unit continued to play music without any problems.

PNKP237, 2025-10-07:
Thanks for sharing your findings. I'm thinking about removing the speed readout because it seems to contribute a lot of issues... The displays aren't meant to receive a new message every 300ms, the radio usually resends the data every 5 seconds.
The click and restart happened to me once on a 2h drive but I didn't notice any particular reason it would crash so I couldn't replicate it. I'll add some functionality to force the display reinitialization in next version as a dirty fix when if its ever needed.

Closed 2025-09-04.
