PNKP237/EHU32/(commit log)

2024-03-18 EHU32 v0.7
    Added proper conversion to UTF-16, audio metadata containing accented characters is now supported*
    Switched from delay to vTaskDelay
    Extended the RX buffer to catch more events, seems to have no ill effects
    *various displays may not support some extended latin characters, thus some strings may not be displayed in full - in such cases all the text coming after "unrecognized" letter is not shown at all
2024-04-10 EHU32 v0.8
    Now blocks "Aux" messages with high accuraccy by abusing ISO 15765-2 flow control
    Tweaked timings
2024-05-06 EHU32 v0.9
    Major code refactor, parts of the program now run in different FreeRTOS tasks
    Message processing is now done asynchronously - processing messages, text or running button macros does not cause CAN messages to be dropped
    Optimized text processing
    Revamped radio message blocking, tweaked timings
    "Measurement mode" can now be run in vehicles without ECC module (detected automatically), which results in limited data provided by the display module
    Added a single line measurement mode, displaying only coolant temperature - accessible by holding "3" on the radio panel
2024-08-08 EHU32 v0.9.2
    Increased stability in measurement modes, the messages are now sent less frequently
    Added a watchdog task, reset by radio messages
    Extended time before automatic AC macro kicks in after entering the AC menu
    [A2DP.ino, CAN.ino, EHU32.ino, OTA.ino]
2024-10-21 EHU32 v0.9.3
    Extended message filtering, added a task to look for Aux string
    Tweaked timings once again
    Improved ISO 15765-2 compatibility
2025-04-06 EHU32 v0.9.4
    Bug fixes
    Using FreeRTOS event groups instead of bools in global scope
    Extended ISO15765-2 transmission compatibility
    EHU32 now scans for used IDs, attemps to use them, saving the results to flash (first boot can now take about 30 seconds)
    Play pause button won't conflict with UHP if it is detected
    Added battery voltage readout for vehicles without ECC (thanks @xymetox)
    Erratic battery voltage detection assumes a Vectra C ECC, falling back to reading voltage from the display
    Extended headunit message processing to detect not only Aux but also balance/bass/treble etc. in Sound menu (CD30/CD40)
    OTA mode works alongside CAN now (albeit poorly) and shows the update progress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
    [A2DP.ino, CAN.ino, EHU32.ino, OTA.ino, TextHandler.ino]
2025-05-12 EHU32 v0.9.5
    Reverted back to 255 bytes max payload for display messages, seems that Delphi-Grundig GID doesn't like longer messages
    Changed the AC toggle to trigger on long presses instead
    Tweaked the logic for blocking Aux frames that are send in the same ISO 15765-2 as status messages (ID 5000)
    [A2DP.ino, CAN.ino, TextHandler.ino]
